alemorf/k155re3_k556rt4_programmer/device.jpg

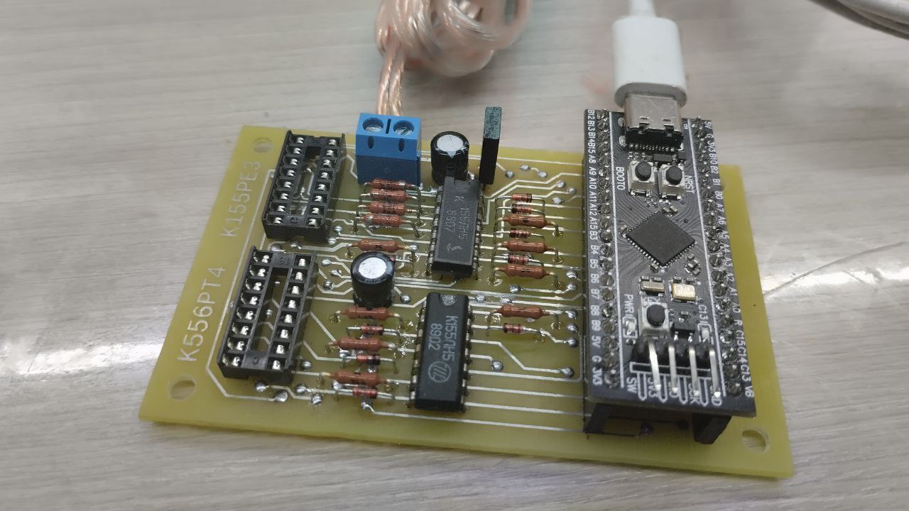
device.jpg
