alemorf/k155re3_k556rt4_programmer/README.md

Программатор микросхем К155РЕ3 и К556РТ4.

Используется плата bluepill с микроконтроллером STM32F401, буфер К555АП6 и еще 2 микросхемы К155ЛН5.
Программатор подключается к компьютеру по USB.
В компьютере появляется COM-порт в нем консоль.
Подключаетесь любым терминалом.

Команды:

re3                     - Выбор микросхемы К155РЕ3

rt4                     - Выбор микросхемы К556РТ4

ADDR: BYTE BYTE BYTE... - Ввод данных для программирования

clear                   - Удалить введенные данные

print                   - Вывести в консоль введенные данные

read                    - Прочитать данные из микросхемы

verify                  - Сравнить введенные данные с микросхемой

empty                   - Проверить, что микросхема ни разу не записывалась

write                   - Записать данные в микросхему

Лицензия: GNU
