alemorf/k155re3_k556rt4_programmer/circuit.png

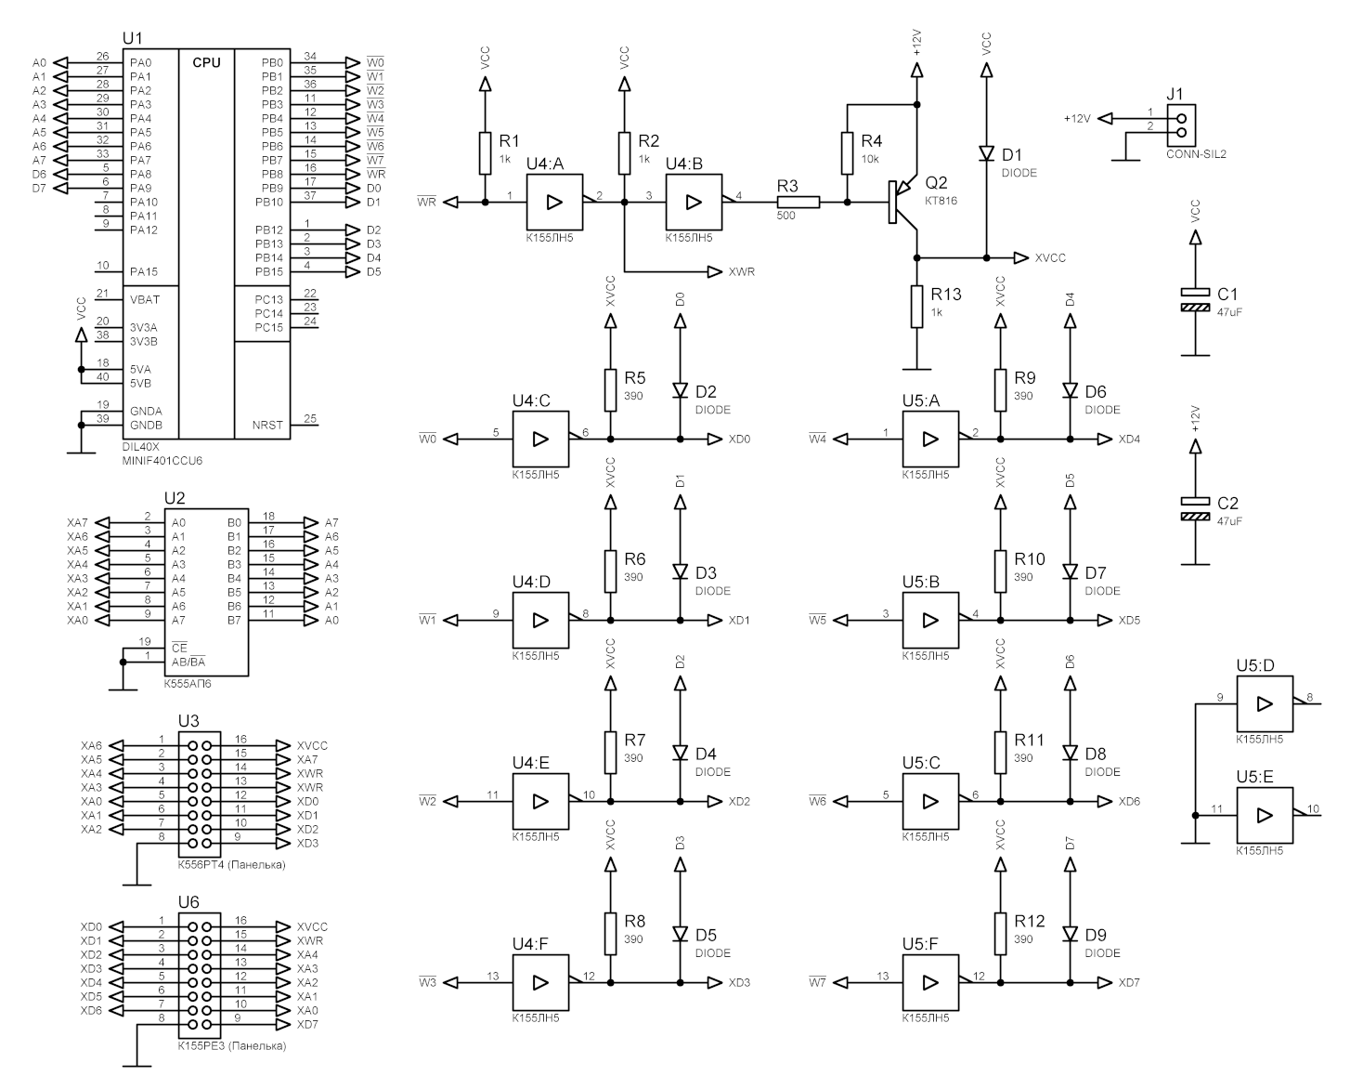
circuit.png
