alemorf/k155re3_k556rt4_programmer/console.png

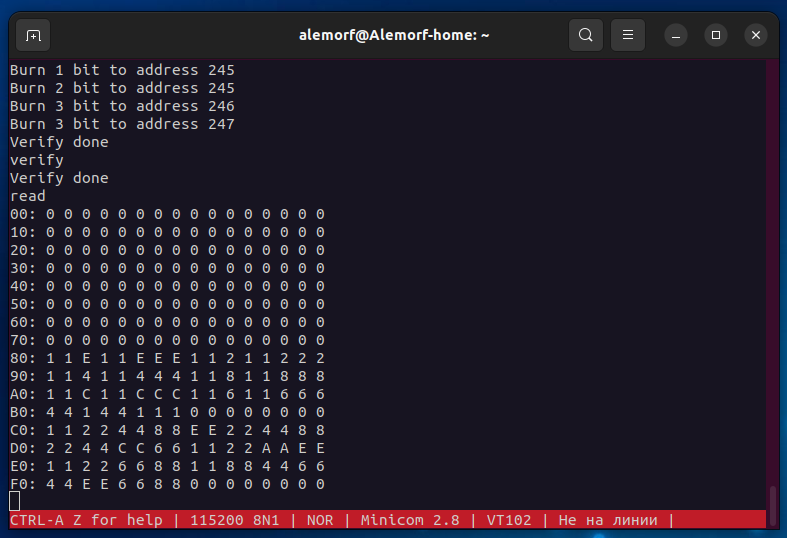
console.png
