alemorf/k155re3_k556rt4_programmer/pcb2.png

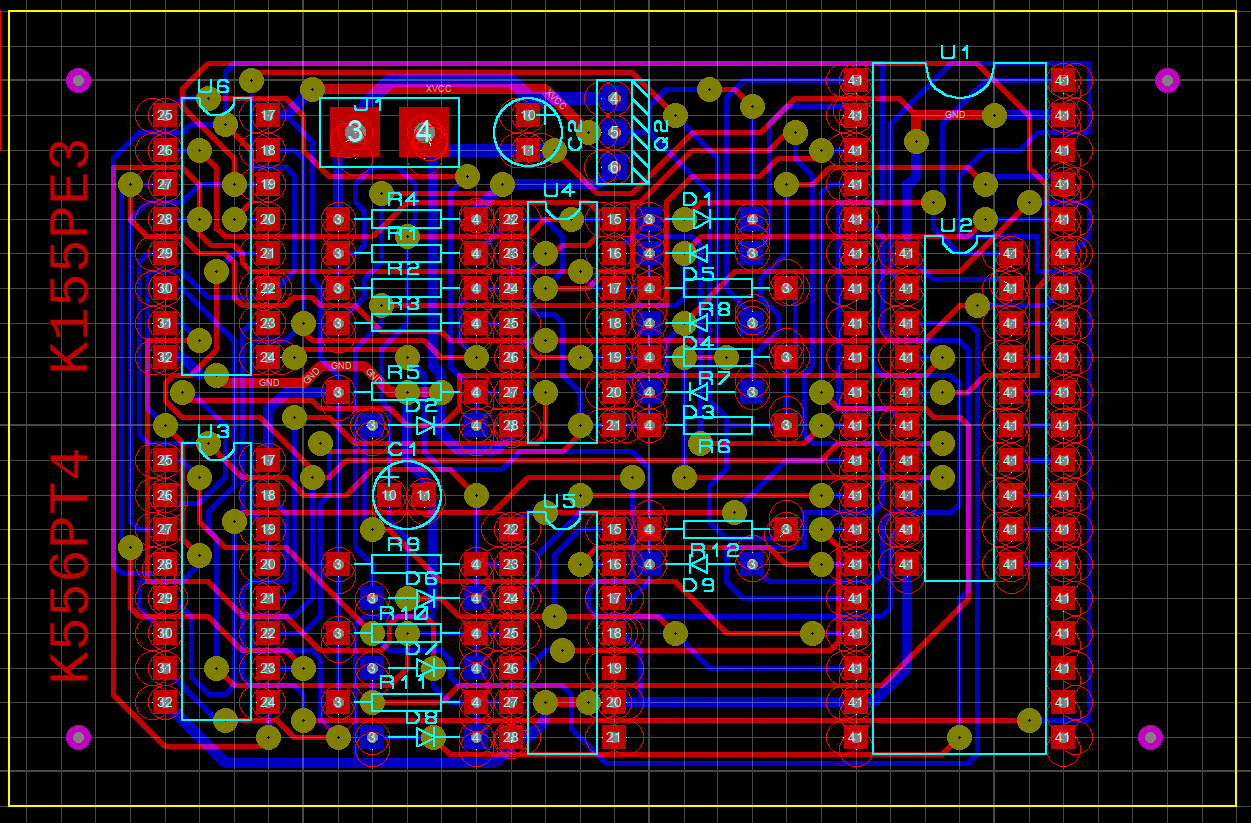
pcb2.png
