alemorf/k155re3_k556rt4_programmer/pcb.png

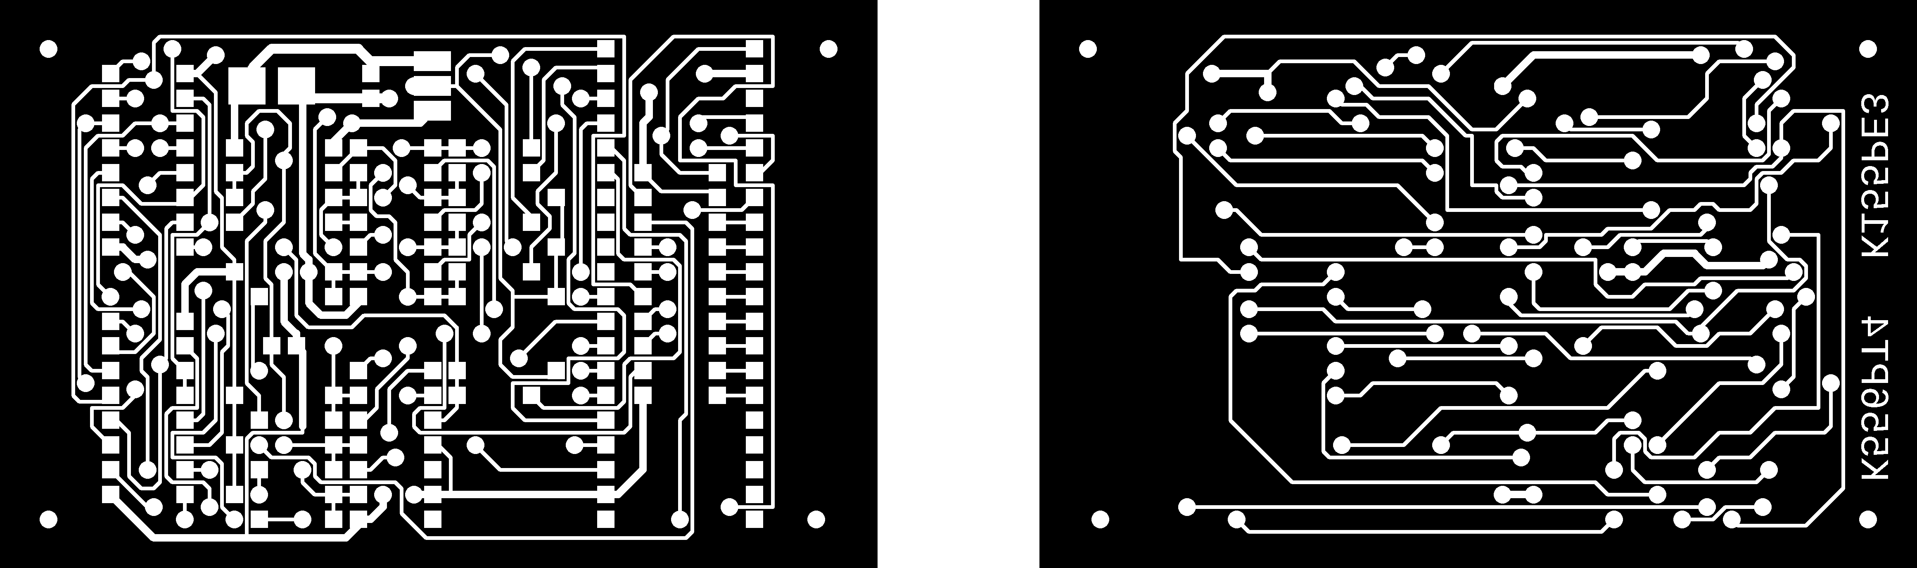
pcb.png
