alemorf/k155re3_k556rt4_programmer/(list of files, drawings)

Other design files:
circuit_pcb/rt4.dsn
circuit_pcb/rt4.LYT
