alemorf/k155re3_k556rt4_programmer/firmware/rt4_firmware.ioc

Mcu.UserName=STM32F401CCUx
PA0-WKUP.Signal=GPIO_Output
PA1.Signal=GPIO_Output
PA11.Signal=USB_OTG_FS_DM
PA12.Signal=USB_OTG_FS_DP
PA13.Signal=SYS_JTMS-SWDIO
PA14.Signal=SYS_JTCK-SWCLK
PA2.Signal=GPIO_Output
PA3.Signal=GPIO_Output
PA4.Signal=GPIO_Output
PA5.Signal=GPIO_Output
PA6.Signal=GPIO_Output
PA7.Signal=GPIO_Output
PA8.Signal=GPIO_Input
PA9.Signal=GPIO_Input
PB0.Signal=GPIO_Output
PB1.Signal=GPIO_Output
PB10.Signal=GPIO_Input
PB12.Signal=GPIO_Input
PB13.Signal=GPIO_Input
PB14.Signal=GPIO_Input
PB15.Signal=GPIO_Input
PB2.Signal=GPIO_Output
PB3.Signal=GPIO_Output
PB4.Signal=GPIO_Output
PB5.Signal=GPIO_Output
PB6.Signal=GPIO_Output
PB7.Signal=GPIO_Output
PB8.Signal=GPIO_Output
PB9.Signal=GPIO_Input
PC13-ANTI_TAMP.Signal=GPIO_Output
